jreeve-nl/led-supply/README.md

# led-supply
Nice power factor corrected switching LED lighting driver
