jreeve-nl/led-supply/kicad/STEP_LM301H.stp

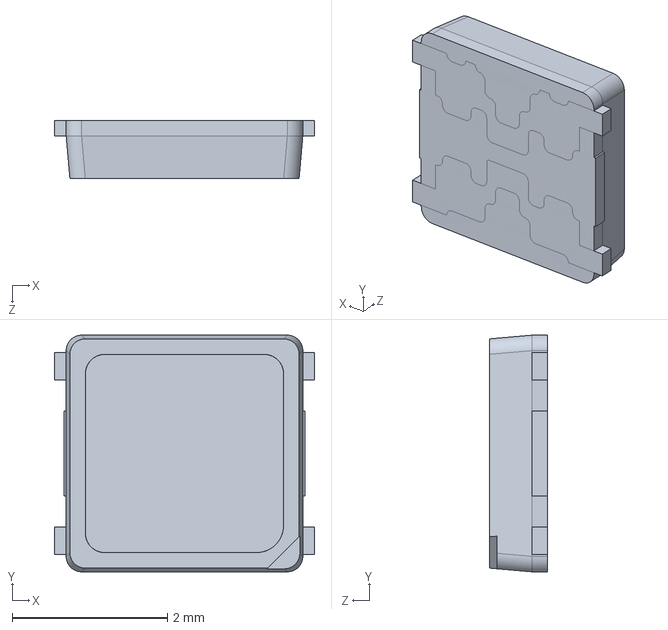
[picture p8: CAD file, 2024-07-14]
kicad/STEP_LM301H.stp
3.35 x 3.05 x 0.751 mm
