jreeve-nl/led-supply/kicad/DXF_LM301H.dxf

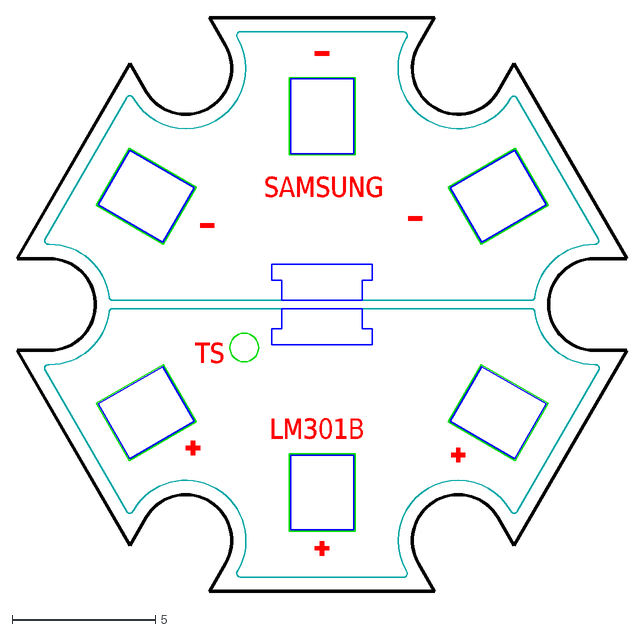
[picture p9: CAD file, 2024-07-14]
kicad/DXF_LM301H.dxf
SAMSUNG
LM301B
TS
