jreeve-nl/led-supply/kicad/kicad-3d/TPS564208DDCT.step

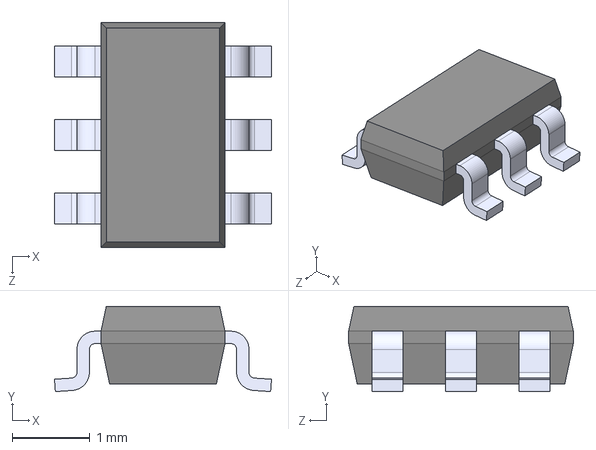
[picture p10: CAD file, 2024-07-14]
kicad/kicad-3d/TPS564208DDCT.step
2.80 x 1.10 x 2.90 mm
