jreeve-nl/led-supply/(list of files, cad)

Other CAD files:
openscad/roundedcube.scad
