jreeve-nl/led-supply/(commit log)

2021-01-01 Add diode bridge simulation.
    [bridge_sim_1.sch]
2021-01-04 Checkpoint buck converter design.
2021-01-05 Add buck calculations.
2021-01-05 Add buck converter simulation.
    [buck_sim_1.sch]
2021-01-06 Tidy up and correct buck simulation options to obtain convergence.
    [bridge_sim_1.sch, bridge_sim_active_pfc.sch, buck_sim_1.sch]
2021-01-08 Add SEPIC calculations and add buck converter simulation results.
2021-01-10 Add local symbol library repo. Create subsheets. Re-organise directory structure.
    [aux-supply.kicad_sch, connectivity.kicad_sch, led-string.kicad_sch, led-supply.kicad_pcb, led-supply.kicad_sch, rectifier-control.kicad_sch, rectifier.kicad_sch]
2021-01-19 Update SEPIC sim with parasitics.
    [buck_sim_1.sch, sepic_ac_line_sim_1.sch, sepic_sim_1.sch, sepic_sim_parasitics_1.sch]
2021-01-31 Add prototype STM32 NUCLEO shield/hat/whatever.
    [led-supply-nucleo.kicad_pcb, led-supply-nucleo.sch, power-converter.sch, stm32-nucleo.sch]
2021-09-01 Rename qucs-s project directory.
    [bridge_sim_1.sch, bridge_sim_active_pfc.sch, buck_sim_1.sch, sepic_ac_line_sim_1.sch, sepic_sim_1.sch, sepic_sim_parasitics_1.sch]
2021-09-02 Initial go at PFC. Work-in-progress.
    [pwm_boost_rectifier_isolated.sch, pwm_boost_rectifier_isolated_w_control.sch]
2023-06-24 Add design scripts. Update footprints and symbol submodules. Add simulation.
    [sepic_current_mode_control.sch, sepic_feedback_control_1.sch, sepic_sim_parasitics_1.sch]
2023-06-24 Add Nucleo based board for prototyping.
    [led-supply-nucleo.kicad_pcb, led-supply-nucleo.sch, power-converter.sch, stm32-nucleo.sch]
2023-07-05 Add submodules and openscad design for test PSU
    [project-box.scad, roundedcube.scad, threadedinsertpost.scad]
2024-07-14 Very messy checkpointing post filling of system disk.
    [DXF_LM301H.dxf, STEP_LM301H.stp, TPS564208DDCT.step, aux-supply.kicad_sch, boost_1.sch, boost_single_nrf540z_1.sch, bridge_1.sch, bridge_active_pfc.sch]
